dawidryba/wled-fence-post-light/docs/images/schematic_led.png

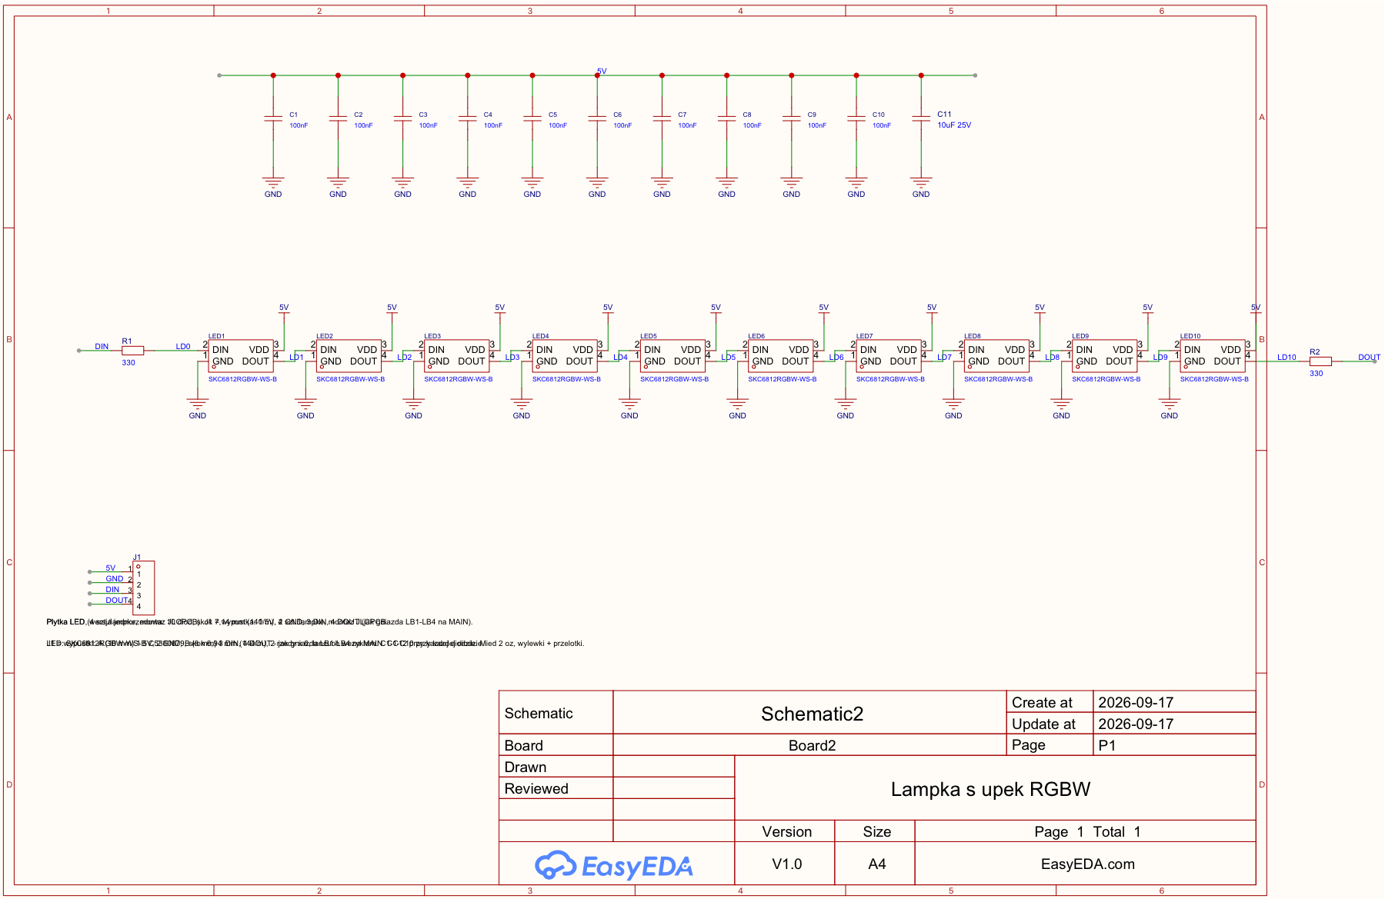
docs/images/schematic_led.png
