dawidryba/wled-fence-post-light/docs/pl/rys1_widok_z_gory.png

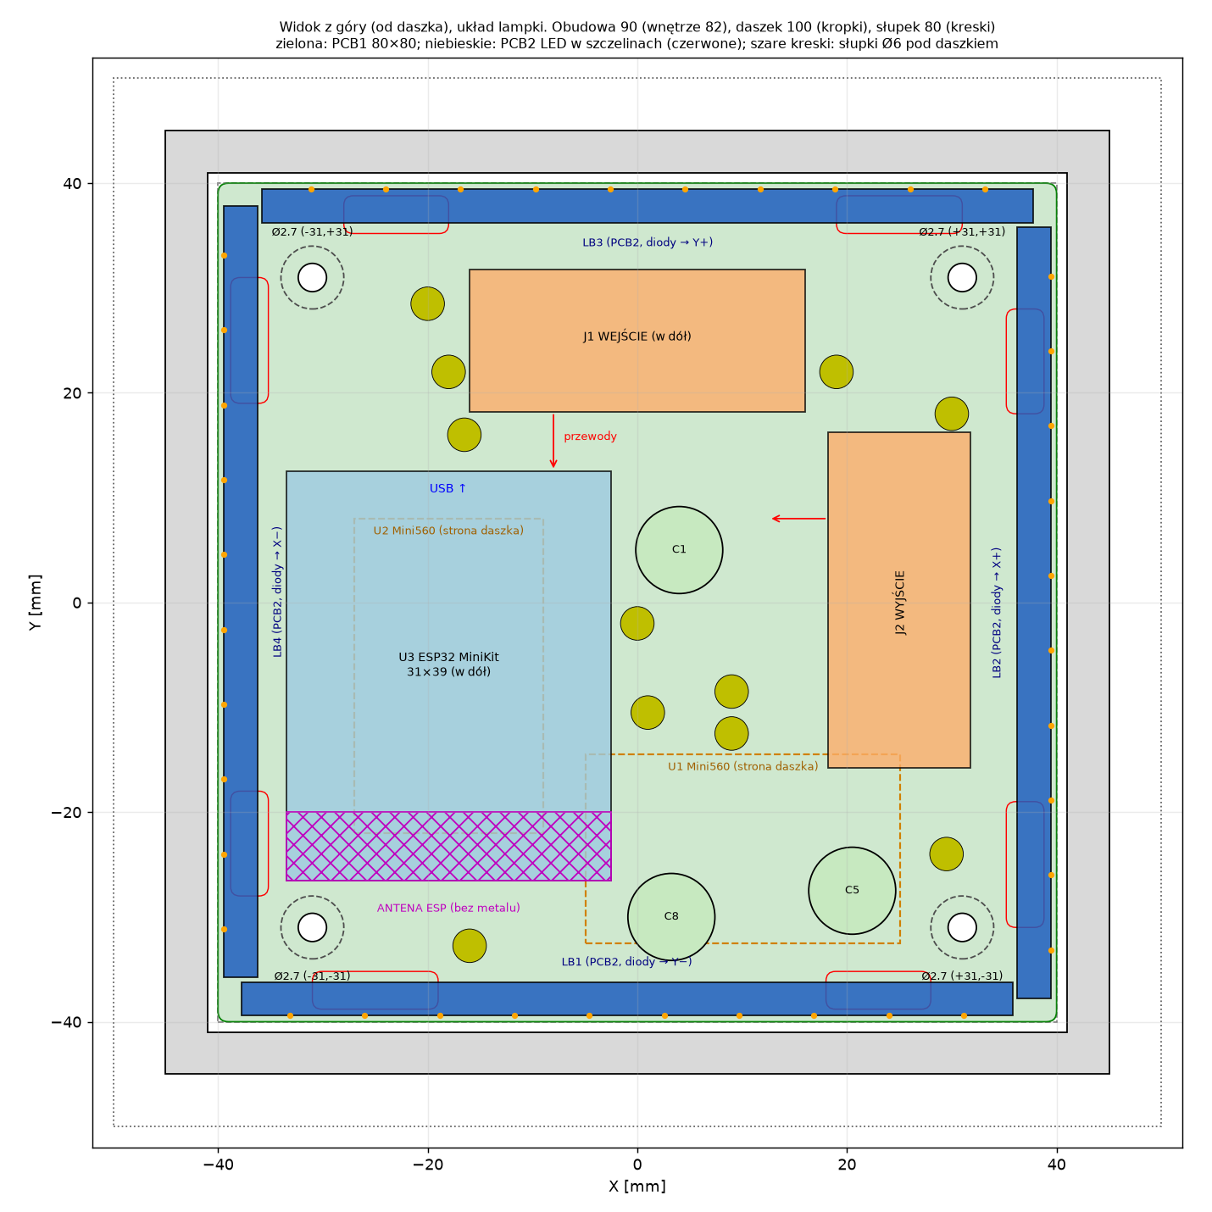
docs/pl/rys1_widok_z_gory.png
