dawidryba/wled-fence-post-light/docs/pl/rys2_przekroj.png

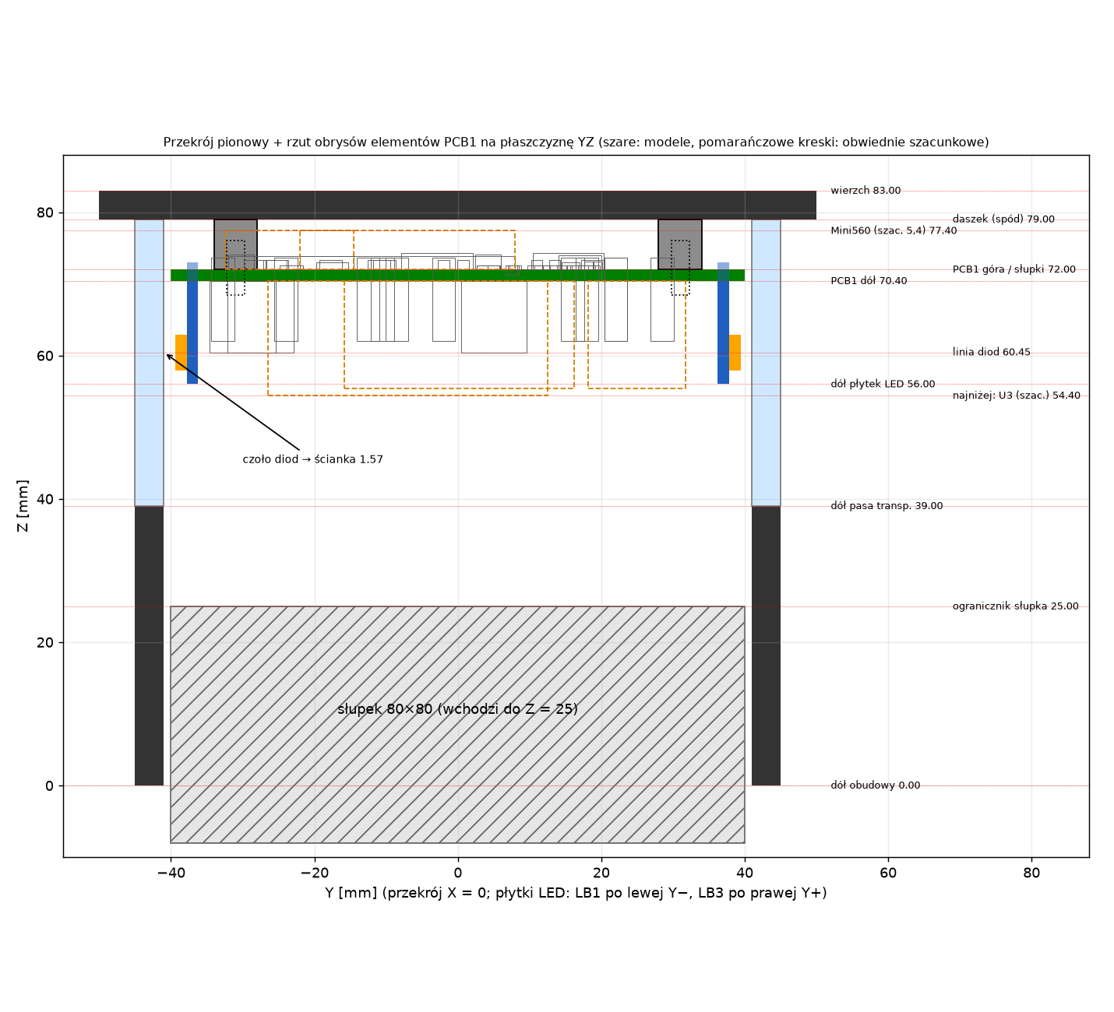
docs/pl/rys2_przekroj.png
