dawidryba/wled-fence-post-light/docs/pl/rys3_strefy_wysokosci.png

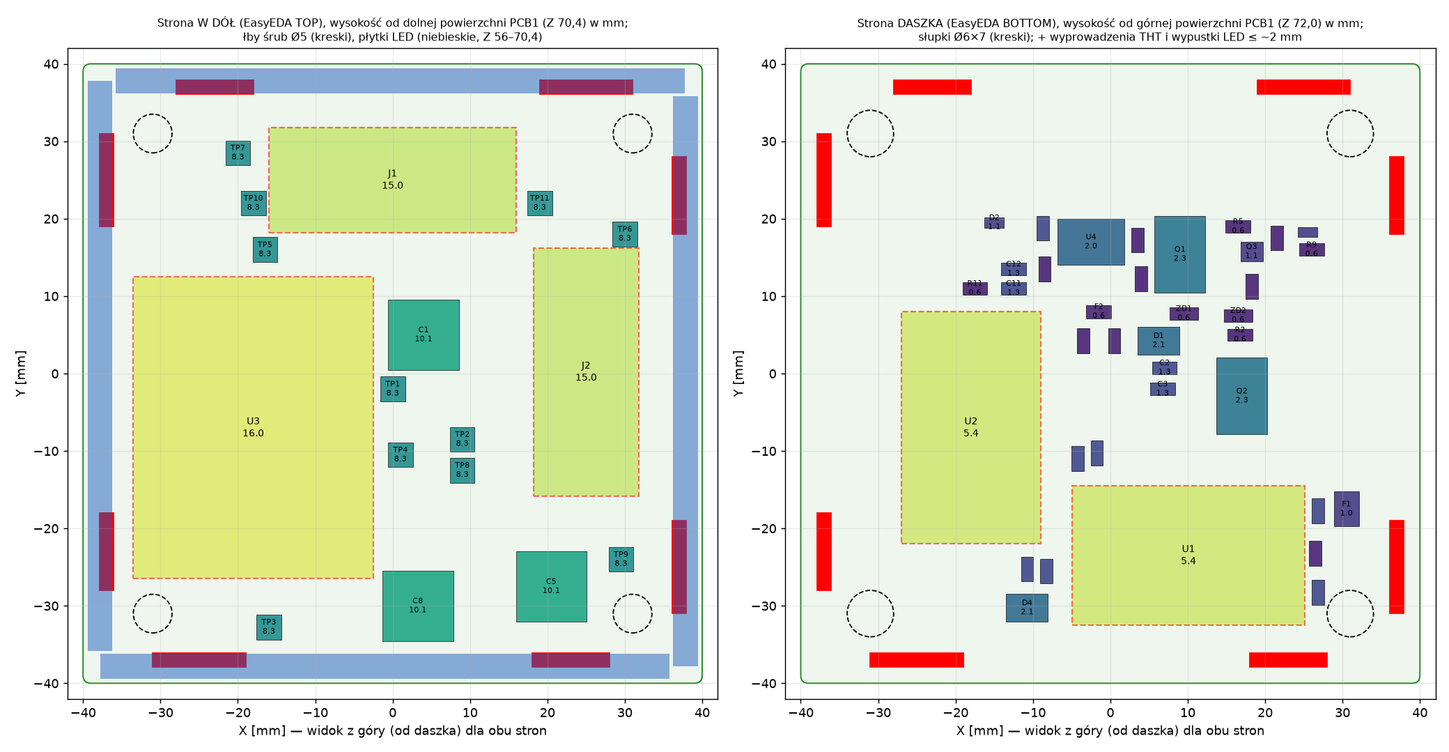
docs/pl/rys3_strefy_wysokosci.png
