dawidryba/wled-fence-post-light/pcb/manufacturing/PCB1_main_bom.csv

No. | Quantity | Comment | Designator | Footprint | Value | Manufacturer Part | Manufacturer | Supplier Part | Supplier
1 | 2 | 220uF 35V | C1,C5 | CAP-SMD_BD8.0-L8.3-W8.3-RD | 220uF 35V | VZH221M1VTR-0810 | Lelon(立隆) | VZH221M1VTR-0810.1 | LCSC
2 | 5 | 10uF 25V | C2,C6,C9,C11,C13 | C1206 | 10uF 25V | CL31B106KAHNNNE | SAMSUNG(三星) | CL31B106KAHNNNE.1 | LCSC
3 | 6 | 100nF | C3,C7,C10,C12,C14,C15 | C1206 | 100nF | CL31B104KBCNNNC | SAMSUNG(三星) | CL31B104KBCNNNC.1 | LCSC
4 | 1 | 470uF 16V | C8 | CAP-SMD_BD8.0-L8.3-W8.3-RD | 470uF 16V | VZH471M1CTR-0810 | Lelon(立隆) | VZH471M1CTR-0810.1 | LCSC
5 | 1 | SMBJ15A | D1 | SMB_L4.6-W3.6-LS5.3-RD |  | SMBJ15A | MDD(辰达半导体) | SMBJ15A_C113988.1 | LCSC
6 | 2 | PESD5V0S1BA | D2,D3 | SOD-323_L1.7-W1.3-LS2.5-BI |  | PESD5V0S1BA | TECH PUBLIC(台舟) | PESD5V0S1BA_C2827694.1 | LCSC
7 | 1 | SMBJ5.0A | D4 | SMB_L4.6-W3.6-LS5.3-RD | SMBJ5.0A | SMBJ5.0A | MDD(辰达半导体) | SMBJ5.0A-C113974.1 | LCSC
8 | 1 | 1812L300/30GR | F1 | F1812 | 3A PTC | 1812L300/30GR | LUTE(陆特) | 1812L300/30GR.1 | LCSC
9 | 1 | JK-nSMD050-30 | F2 | F1206 | 0.5A PTC | JK-nSMD050-30 | JK(金科) | JK-NSMD050-30V.1 | LCSC
10 | 1 | KF235-3.81 8P WEJSCIE | J1 | CONN-TH_16P-P3.50_2601-1108 |  | KF235-3.81-2P x4 (8 torow) | Cixi Kefa (KF235) | KF235-3.81-2P (AliExpress) | AliExpress
11 | 1 | KF235-3.81 8P WYJSCIE | J2 | CONN-TH_16P-P3.50_2601-1108 |  | KF235-3.81-2P x4 (8 torow) | Cixi Kefa (KF235) | KF235-3.81-2P (AliExpress) | AliExpress
12 | 1 | LAMPKA_SJ3 | JP1 | LAMPKA_SJ3 |  |  |  | PZ254V-11-03P_C2937625.1
13 | 4 | LAMPKA_LB_SLOT | LB1,LB2,LB3,LB4 | LAMPKA_LB_SLOT |  |  |  | PZ254V-11-04P.1
14 | 2 | AOD4185 | Q1,Q2 | TO-252-3_L6.6-W6.1-P4.57-LS9.9-BR-CW |  | AOD4185 | AOS | AOD4185_C400894.1 | LCSC
15 | 1 | 2N7002 | Q3 | SOT-23-3_L2.9-W1.3-P1.90-LS2.4-BR |  | 2N7002 | CJ(江苏长电/长晶) | 2N7002.1 | LCSC
16 | 2 | 47k | R1,R2 | R1206 | 47k | RC1206FR-0747KL | YAGEO(国巨) | RC1206FR-0747KL.1 | LCSC
17 | 1 | 4.7k | R3 | R1206 | 4.7k | 1206W4F4701T5E | UNI-ROYAL(厚声) | 1206W4F4701T5E.1 | LCSC
18 | 3 | 100 | R4,R6,R9 | R1206 | 100 | 1206W4F1000T5E | UNI-ROYAL(厚声) | 1206W4F1000T5E.1 | LCSC
19 | 2 | 100k | R5,R12 | R1206 | 100k | 1206W4F1003T5E | UNI-ROYAL(厚声) | 1206W4F1003T5E.1 | LCSC
20 | 1 | 220 | R7 | R1206 | 220 | 1206W4F2200T5E | UNI-ROYAL(厚声) | 1206W4F2200T5E.1 | LCSC
21 | 1 | 10k | R8 | R1206 | 10k | 1206W4F1002T5E | UNI-ROYAL(厚声) | 1206W4F1002T5E.1 | LCSC
22 | 2 | 2.2k | R10,R11 | R1206 | 2.2k | 1206W4F2201T5E | UNI-ROYAL(厚声) | 1206W4F2201T5E.1 | LCSC
23 | 4 | TP-红色测试点 | TP1,TP2,TP3,TP4 | TESTPOINT-TH_BD3.2 |  | TP-红色测试点 |  | TP-红色测试点.1 | LCSC
24 | 5 | TP-黄色测试点 | TP5,TP6,TP9,TP10,TP11 | TESTPOINT-TH_BD3.2 |  | TP-黄色测试点 |  | TP-黄色测试点.1 | LCSC
25 | 2 | TP-黑色测试点 | TP7,TP8 | TESTPOINT-TH_BD3.2 |  | TP-黑色测试点 |  | TP-黑色测试点.1 | LCSC
26 | 2 | mini5605V5A输出电源模块 | U1,U2 | COMM-SMD_MINI5605V5A |  | mini5605V5A输出电源模块 |  | MINI5605V5A输出电源模块.1 | LCSC
27 | 1 | ESP32 D1 Mini (MH-ET LIVE MiniKit) | U3 | LAMPKA_ESP32_MINIKIT |  | ESP32 D1 Mini (MH-ET LIVE MiniKit) |  | 12251210CNG0S190001.1
28 | 1 | SN74AHCT125DR | U4 | SOIC-14_L8.7-W3.9-P1.27-LS6.0-BL |  | SN74AHCT125DR | TI(德州仪器) | SN74AHCT125DR.1 | LCSC
29 | 2 | BZT52C12 | ZD1,ZD2 | SOD-123_L2.7-W1.6-LS3.7-RD | 12V | BZT52C12 | MDD(辰达半导体) | BZT52C12.1 | LCSC
