dawidryba/wled-fence-post-light/pcb/manufacturing/PCB2_LED_panel_bom.csv

No. | Quantity | Comment | Designator | Footprint | Value | Manufacturer Part | Manufacturer | Supplier Part | Supplier
1 | 10 | 100nF | C1,C2,C3,C4,C5,C6,C7,C8,C9,C10 | C0603 | 100nF | CC0603KRX7R9BB104 | YAGEO(国巨) | CC0603KRX7R9BB104.1 | LCSC
2 | 1 | 10uF 25V | C11 | C0805 | 10uF 25V | CL21A106KAYNNNE | SAMSUNG(三星) | CL21A106KAYNNNE.1 | LCSC
3 | 1 | LAMPKA_LED_TAB | J1 | LAMPKA_LED_TAB |  |  |  | PZ254V-11-04P.1
4 | 10 | SKC6812RGBW-WS-B | LED1,LED2,LED3,LED4,LED5,LED6,LED7,LED8,LED9,LED10 | LED-SMD_4P-L5.0-W4.9-BR |  | SKC6812RGBW-WS-B | OPSCO(欧思科) | SKC6812RGBW-WS-B.1 | LCSC
5 | 2 | 330 | R1,R2 | R0603 | 330 | 0603WAF3300T5E | UNI-ROYAL(厚声) | 0603WAF3300T5E.1 | LCSC
