dawidryba/wled-fence-post-light/pcb/step/electronics_assembly.step

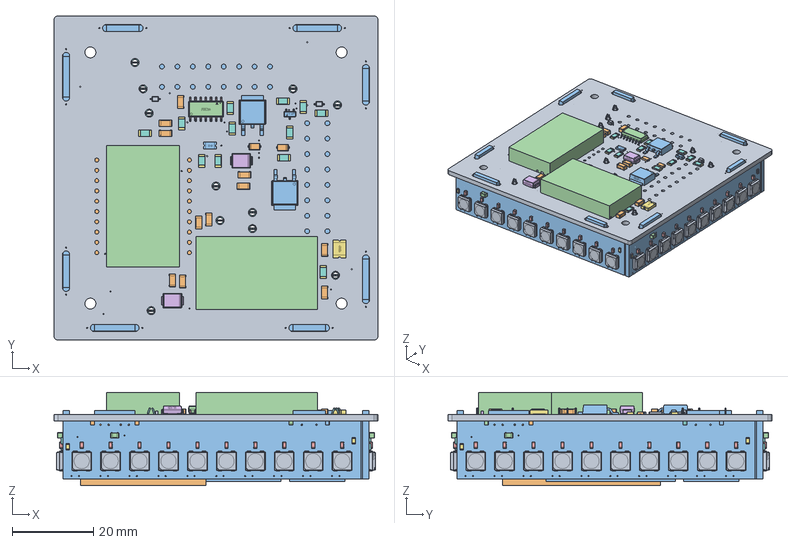
[picture p13: CAD file, 2026-10-31]
pcb/step/electronics_assembly.step
80.0 x 80.0 x 23.0 mm
Board~ostY
C1206~C1206_L3.2-W1.6-H1.3~duGf x 11
SOT-23-3_L2.9-W1.3-P1.90-LS2.4-BR~SOT-23-3P_ L2.9-W1.3-H1.0-LS2.4-P0.95~RIX3
SOT-23-3_L2.9-W1.3-P1.90-LS2.4-BR~SOT-23-3P_ L2.9-W1.3-H1.0-LS2.4-P0.95~RIX004
SOT-23-3_L2.9-W1.3-P1.90-LS2.4-BR~SOT-23-3P_ L2.9-W1.3-H1.0-LS2.4-P0.95~RIX005
SOT-23-3_L2.9-W1.3-P1.90-LS2.4-BR~SOT-23-3P_ L2.9-W1.3-H1.0-LS2.4-P0.95~RIX006
SOT-23-3_L2.9-W1.3-P1.90-LS2.4-BR~SOT-23-3P_ L2.9-W1.3-H1.0-LS2.4-P0.95~RIX007
SOT-23-3_L2.9-W1.3-P1.90-LS2.4-BR~SOT-23-3P_ L2.9-W1.3-H1.0-LS2.4-P0.95~RIX008
SOT-23-3_L2.9-W1.3-P1.90-LS2.4-BR~SOT-23-3P_ L2.9-W1.3-H1.0-LS2.4-P0.95~RIX009
SOT-23-3_L2.9-W1.3-P1.90-LS2.4-BR~SOT-23-3P_ L2.9-W1.3-H1.0-LS2.4-P0.95~RIX010
SOT-23-3_L2.9-W1.3-P1.90-LS2.4-BR~SOT-23-3P_ L2.9-W1.3-H1.0-LS2.4-P0.95~RIX011
SOT-23-3_L2.9-W1.3-P1.90-LS2.4-BR~SOT-23-3P_ L2.9-W1.3-H1.0-LS2.4-P0.95~RIX012
SOT-23-3_L2.9-W1.3-P1.90-LS2.4-BR~SOT-23-3P_ L2.9-W1.3-H1.0-LS2.4-P0.95~RIX013
SOT-23-3_L2.9-W1.3-P1.90-LS2.4-BR~SOT-23-3P_ L2.9-W1.3-H1.0-LS2.4-P0.95~RIX014
SOT-23-3_L2.9-W1.3-P1.90-LS2.4-BR~SOT-23-3P_ L2.9-W1.3-H1.0-LS2.4-P0.95~RIX015
SOT-23-3_L2.9-W1.3-P1.90-LS2.4-BR~SOT-23-3P_ L2.9-W1.3-H1.0-LS2.4-P0.95~RIX016
SOT-23-3_L2.9-W1.3-P1.90-LS2.4-BR~SOT-23-3P_ L2.9-W1.3-H1.0-LS2.4-P0.95~RIX017
SOT-23-3_L2.9-W1.3-P1.90-LS2.4-BR~SOT-23-3P_ L2.9-W1.3-H1.0-LS2.4-P0.95~RIX018
SOT-23-3_L2.9-W1.3-P1.90-LS2.4-BR~SOT-23-3P_ L2.9-W1.3-H1.0-LS2.4-P0.95~RIX019
SMB_L4.6-W3.6-LS5.3-RD~SMB_L4.6-W3.6-LS5.3-RD~o7Bd x 2
R1206~R1206_L3.2-W1.6-H0.6~9JtB x 12
R1206~R1206_L3.2-W1.6-H0.6~9JtB001 x 12
R1206~R1206_L3.2-W1.6-H0.6~9JtB002 x 12
SOD-123_L2.7-W1.6-LS3.7-RD~SOD-123_L2.7-W1.6-H1.4-LS3.7~yyUm x 2
F1206~F1206_L3.2-W1.7-H0.6~Ill9
SOIC-14_L8.7-W3.9-P1.27-LS6.0-BL~SOIC-14_ L8.6-W3.9-H1.8-LS6.0-P1.27~Mzfl
SOIC-14_L8.7-W3.9-P1.27-LS6.0-BL~SOIC-14_ L8.6-W3.9-H1.8-LS6.0-P1.27~Mzfl001
SOIC-14_L8.7-W3.9-P1.27-LS6.0-BL~SOIC-14_ L8.6-W3.9-H1.8-LS6.0-P1.27~Mzfl002
SOIC-14_L8.7-W3.9-P1.27-LS6.0-BL~SOIC-14_ L8.6-W3.9-H1.8-LS6.0-P1.27~Mzfl003
SOIC-14_L8.7-W3.9-P1.27-LS6.0-BL~SOIC-14_ L8.6-W3.9-H1.8-LS6.0-P1.27~Mzfl004
SOIC-14_L8.7-W3.9-P1.27-LS6.0-BL~SOIC-14_ L8.6-W3.9-H1.8-LS6.0-P1.27~Mzfl005
SOIC-14_L8.7-W3.9-P1.27-LS6.0-BL~SOIC-14_ L8.6-W3.9-H1.8-LS6.0-P1.27~Mzfl006
SOIC-14_L8.7-W3.9-P1.27-LS6.0-BL~SOIC-14_ L8.6-W3.9-H1.8-LS6.0-P1.27~Mzfl007
SOIC-14_L8.7-W3.9-P1.27-LS6.0-BL~SOIC-14_ L8.6-W3.9-H1.8-LS6.0-P1.27~Mzfl008
SOIC-14_L8.7-W3.9-P1.27-LS6.0-BL~SOIC-14_ L8.6-W3.9-H1.8-LS6.0-P1.27~Mzfl009
SOIC-14_L8.7-W3.9-P1.27-LS6.0-BL~SOIC-14_ L8.6-W3.9-H1.8-LS6.0-P1.27~Mzfl010
SOIC-14_L8.7-W3.9-P1.27-LS6.0-BL~SOIC-14_ L8.6-W3.9-H1.8-LS6.0-P1.27~Mzfl011
SOIC-14_L8.7-W3.9-P1.27-LS6.0-BL~SOIC-14_ L8.6-W3.9-H1.8-LS6.0-P1.27~Mzfl012
SOIC-14_L8.7-W3.9-P1.27-LS6.0-BL~SOIC-14_ L8.6-W3.9-H1.8-LS6.0-P1.27~Mzfl013
SOIC-14_L8.7-W3.9-P1.27-LS6.0-BL~SOIC-14_ L8.6-W3.9-H1.8-LS6.0-P1.27~Mzfl014
SOIC-14_L8.7-W3.9-P1.27-LS6.0-BL~SOIC-14_ L8.6-W3.9-H1.8-LS6.0-P1.27~Mzfl015
SOIC-14_L8.7-W3.9-P1.27-LS6.0-BL~SOIC-14_ L8.6-W3.9-H1.8-LS6.0-P1.27~Mzfl016
SOIC-14_L8.7-W3.9-P1.27-LS6.0-BL~SOIC-14_ L8.6-W3.9-H1.8-LS6.0-P1.27~Mzfl017
SOIC-14_L8.7-W3.9-P1.27-LS6.0-BL~SOIC-14_ L8.6-W3.9-H1.8-LS6.0-P1.27~Mzfl018
SOIC-14_L8.7-W3.9-P1.27-LS6.0-BL~SOIC-14_ L8.6-W3.9-H1.8-LS6.0-P1.27~Mzfl019
SOIC-14_L8.7-W3.9-P1.27-LS6.0-BL~SOIC-14_ L8.6-W3.9-H1.8-LS6.0-P1.27~Mzfl020
SOIC-14_L8.7-W3.9-P1.27-LS6.0-BL~SOIC-14_ L8.6-W3.9-H1.8-LS6.0-P1.27~Mzfl021
SOIC-14_L8.7-W3.9-P1.27-LS6.0-BL~SOIC-14_ L8.6-W3.9-H1.8-LS6.0-P1.27~Mzfl022
SOIC-14_L8.7-W3.9-P1.27-LS6.0-BL~SOIC-14_ L8.6-W3.9-H1.8-LS6.0-P1.27~Mzfl023
SOIC-14_L8.7-W3.9-P1.27-LS6.0-BL~SOIC-14_ L8.6-W3.9-H1.8-LS6.0-P1.27~Mzfl024
SOIC-14_L8.7-W3.9-P1.27-LS6.0-BL~SOIC-14_ L8.6-W3.9-H1.8-LS6.0-P1.27~Mzfl025
SOIC-14_L8.7-W3.9-P1.27-LS6.0-BL~SOIC-14_ L8.6-W3.9-H1.8-LS6.0-P1.27~Mzfl026
SOIC-14_L8.7-W3.9-P1.27-LS6.0-BL~SOIC-14_ L8.6-W3.9-H1.8-LS6.0-P1.27~Mzfl027
F1812~F1812_L4.5-W3.2-H1.0~vHM2
TESTPOINT-TH_BD3.2~TESTPOINT-TH_BD3.2~D4CD x 11
SOD-323_L1.7-W1.3-LS2.5-BI~SOD-323_L1.7-W1.3-LS2.5-BI~kZJh x 2
SOD-323_L1.7-W1.3-LS2.5-BI~SOD-323_L1.7-W1.3-LS2.5-BI~kZJh001 x 2
SOD-323_L1.7-W1.3-LS2.5-BI~SOD-323_L1.7-W1.3-LS2.5-BI~kZJh002 x 2
SOD-323_L1.7-W1.3-LS2.5-BI~SOD-323_L1.7-W1.3-LS2.5-BI~kZJh003 x 2
SOD-323_L1.7-W1.3-LS2.5-BI~SOD-323_L1.7-W1.3-LS2.5-BI~kZJh004 x 2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
