dawidryba/wled-fence-post-light/enclosure/exports/lampka_kliny_x4.stl

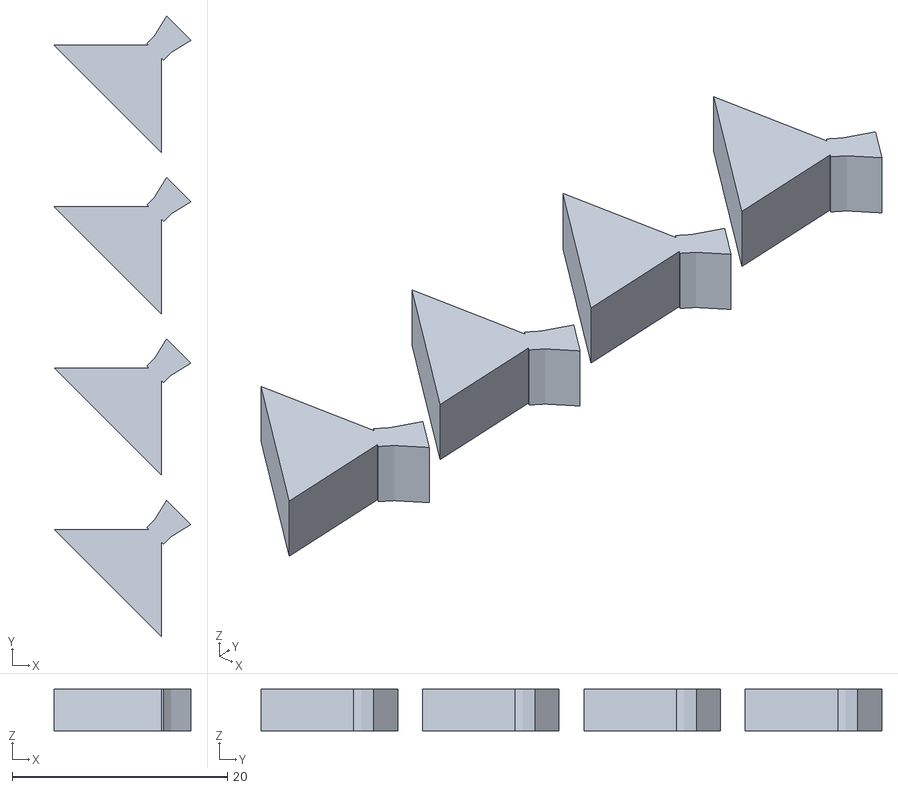
[picture p14: CAD file, 2026-10-31]
enclosure/exports/lampka_kliny_x4.stl
12.7 x 57.7 x 3.90
