dawidryba/wled-fence-post-light/enclosure/makerworld/Fence_post_light_80x80_PETG_AMS.3mf

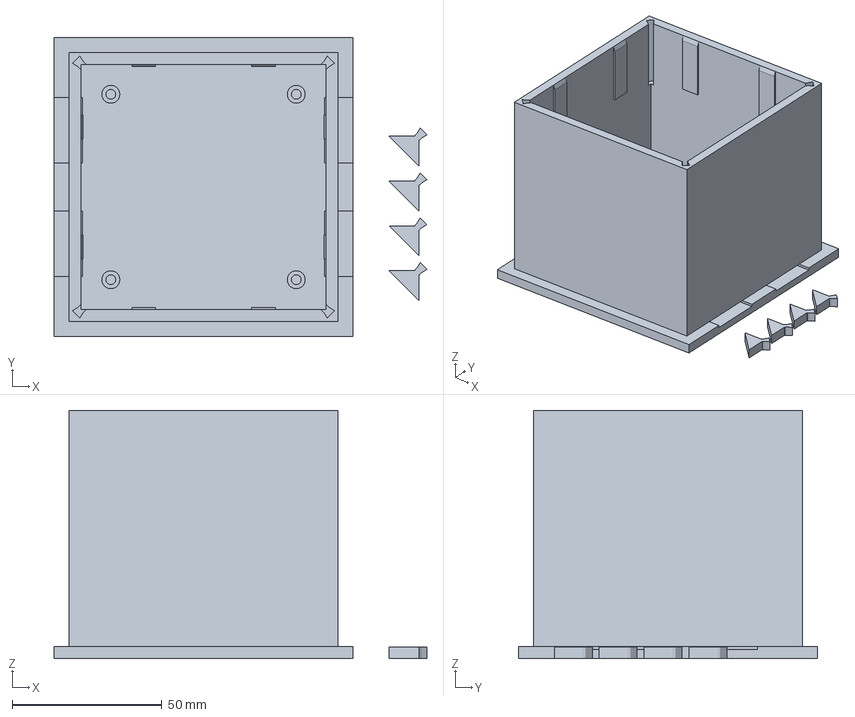
[picture p15: CAD file, 2026-10-31]
enclosure/makerworld/Fence_post_light_80x80_PETG_AMS.3mf
124.7 x 100.0 x 83.0 mm
