dawidryba/wled-fence-post-light/enclosure/exports/lampka.step

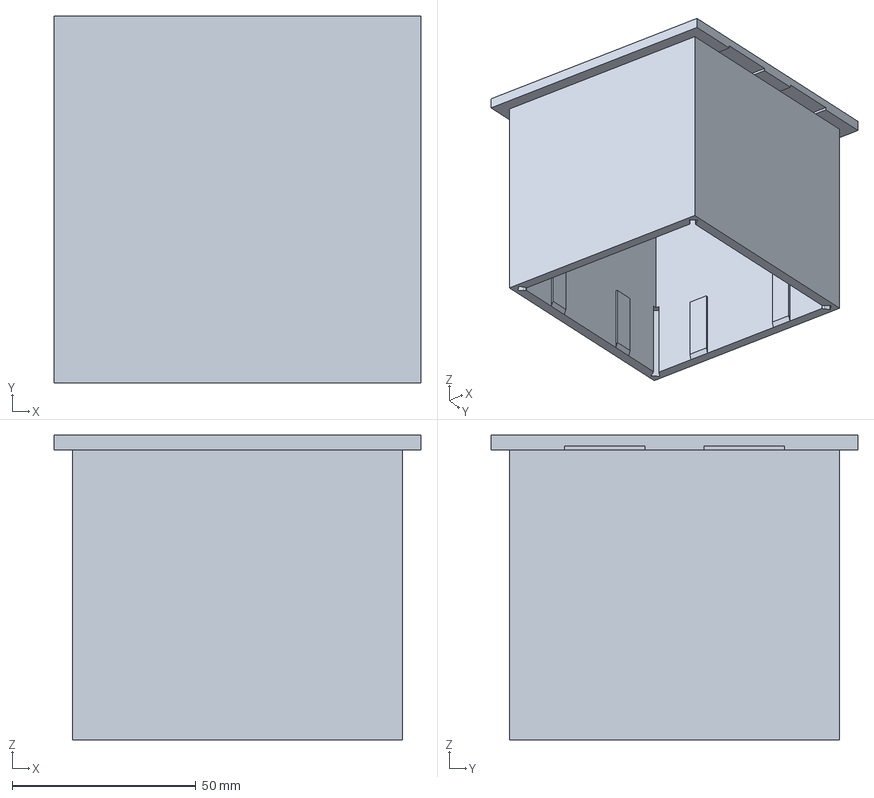
[picture p16: CAD file, 2026-10-31]
enclosure/exports/lampka.step
100.0 x 100.0 x 83.0 mm
