dawidryba/wled-fence-post-light/enclosure/exports/lampka_czarny_dol.stl

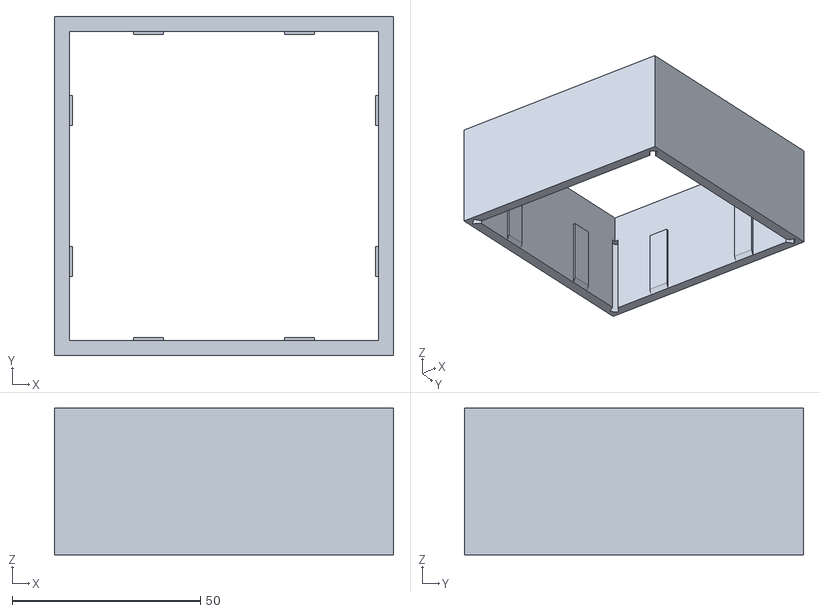
[picture p17: CAD file, 2026-10-31]
enclosure/exports/lampka_czarny_dol.stl
90.0 x 90.0 x 39.0
