dawidryba/wled-fence-post-light/enclosure/exports/lampka_pas_transparentny.stl

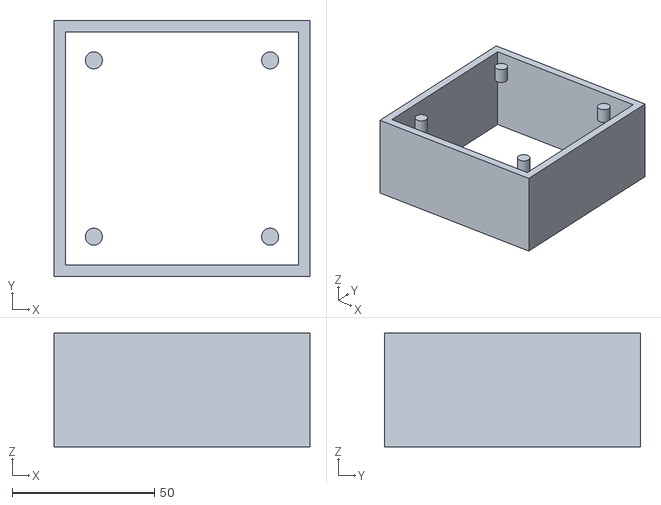
[picture p18: CAD file, 2026-10-31]
enclosure/exports/lampka_pas_transparentny.stl
90.0 x 90.0 x 40.0
