dawidryba/wled-fence-post-light/enclosure/exports/lampka_czarny_daszek.stl

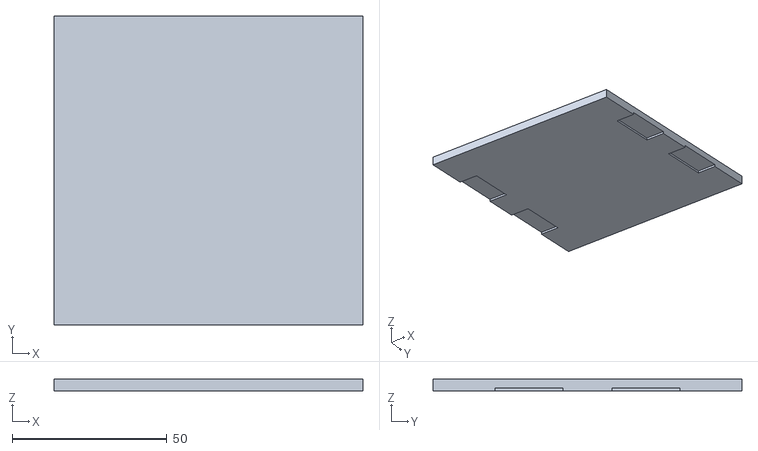
[picture p19: CAD file, 2026-10-31]
enclosure/exports/lampka_czarny_daszek.stl
100.0 x 100.0 x 4.00
