dawidryba/wled-fence-post-light/enclosure/exports/lampka_klin.step

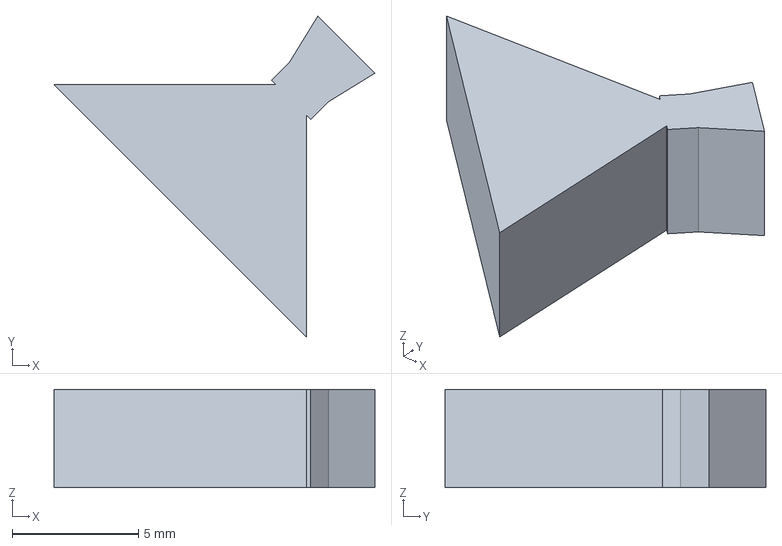
[picture p20: CAD file, 2026-10-31]
enclosure/exports/lampka_klin.step
12.7 x 12.7 x 3.90 mm
