dawidryba/wled-fence-post-light/docs/schematic_led.pdf

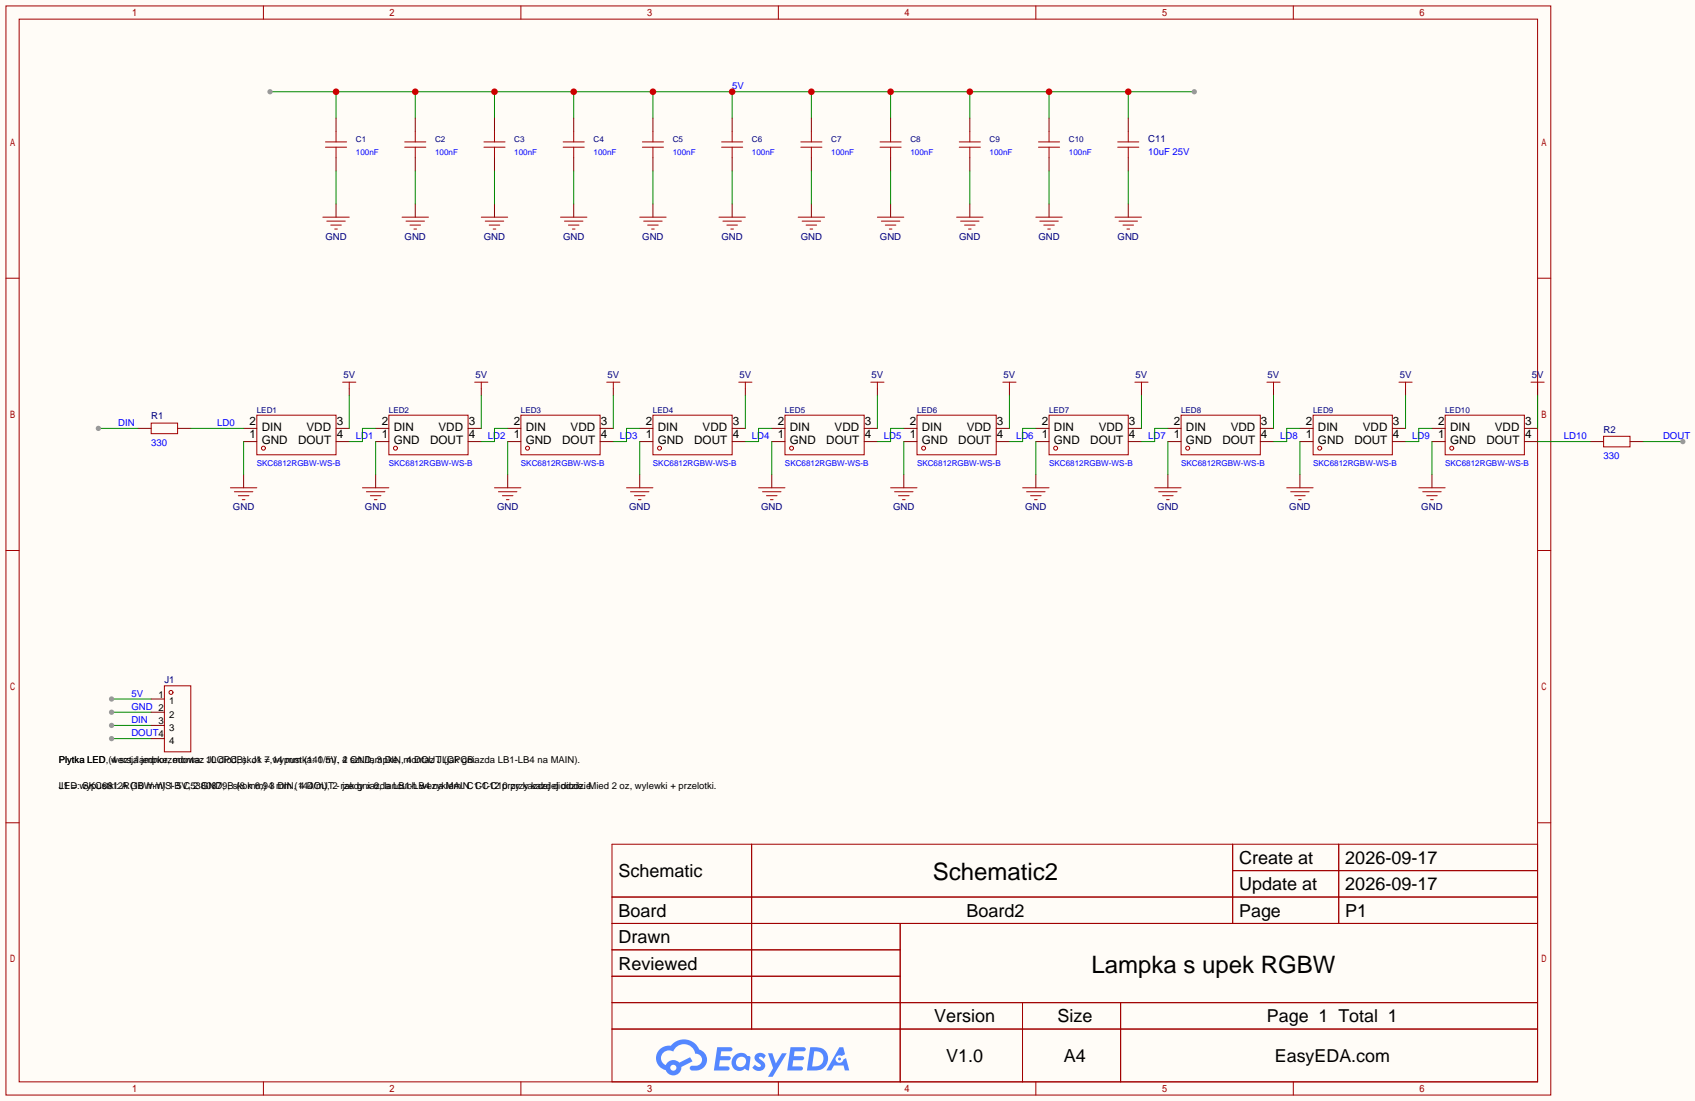
[picture p21: page 1]

Plytka LED (4 szt./lampke, montaz JLCPCB). J1 = wypustka: 1 5V, 2 GND, 3 DIN, 4 DOUT (jak gniazda LB1-LB4 na MAIN).

Plytka LED, wersja jednorzedowa: 10 diod, skok 7,14 mm (140/m). 4 szt./lampke, montaz JLCPCB.

LED: SKC6812RGBW-WS-B C5380879, skok 6,94 mm (144/m), 2 rzedy x 6, lancuch wezykiem. C1-C12 przy kazdej diodzie. Mied 2 oz, wylewki + przelotki.

J1 = wypustki: A (10 mm) 1 5V, 2 GND; B (8 mm) 3 DIN, 4 DOUT - jak gniazda LB1-LB4 na MAIN. C1-C10 przy kazdej diodzie.

Schematic | Schematic2 | Create at | 2026-09-17

Update at | 2026-09-17

Board | Board2 | Page | P1
Drawn | | Lampka s upek RGBW
Reviewed

Version | Size | Page 1 Total 1
V1.0 | A4 | EasyEDA.com
