dawidryba/wled-fence-post-light/docs/schematic_main.pdf

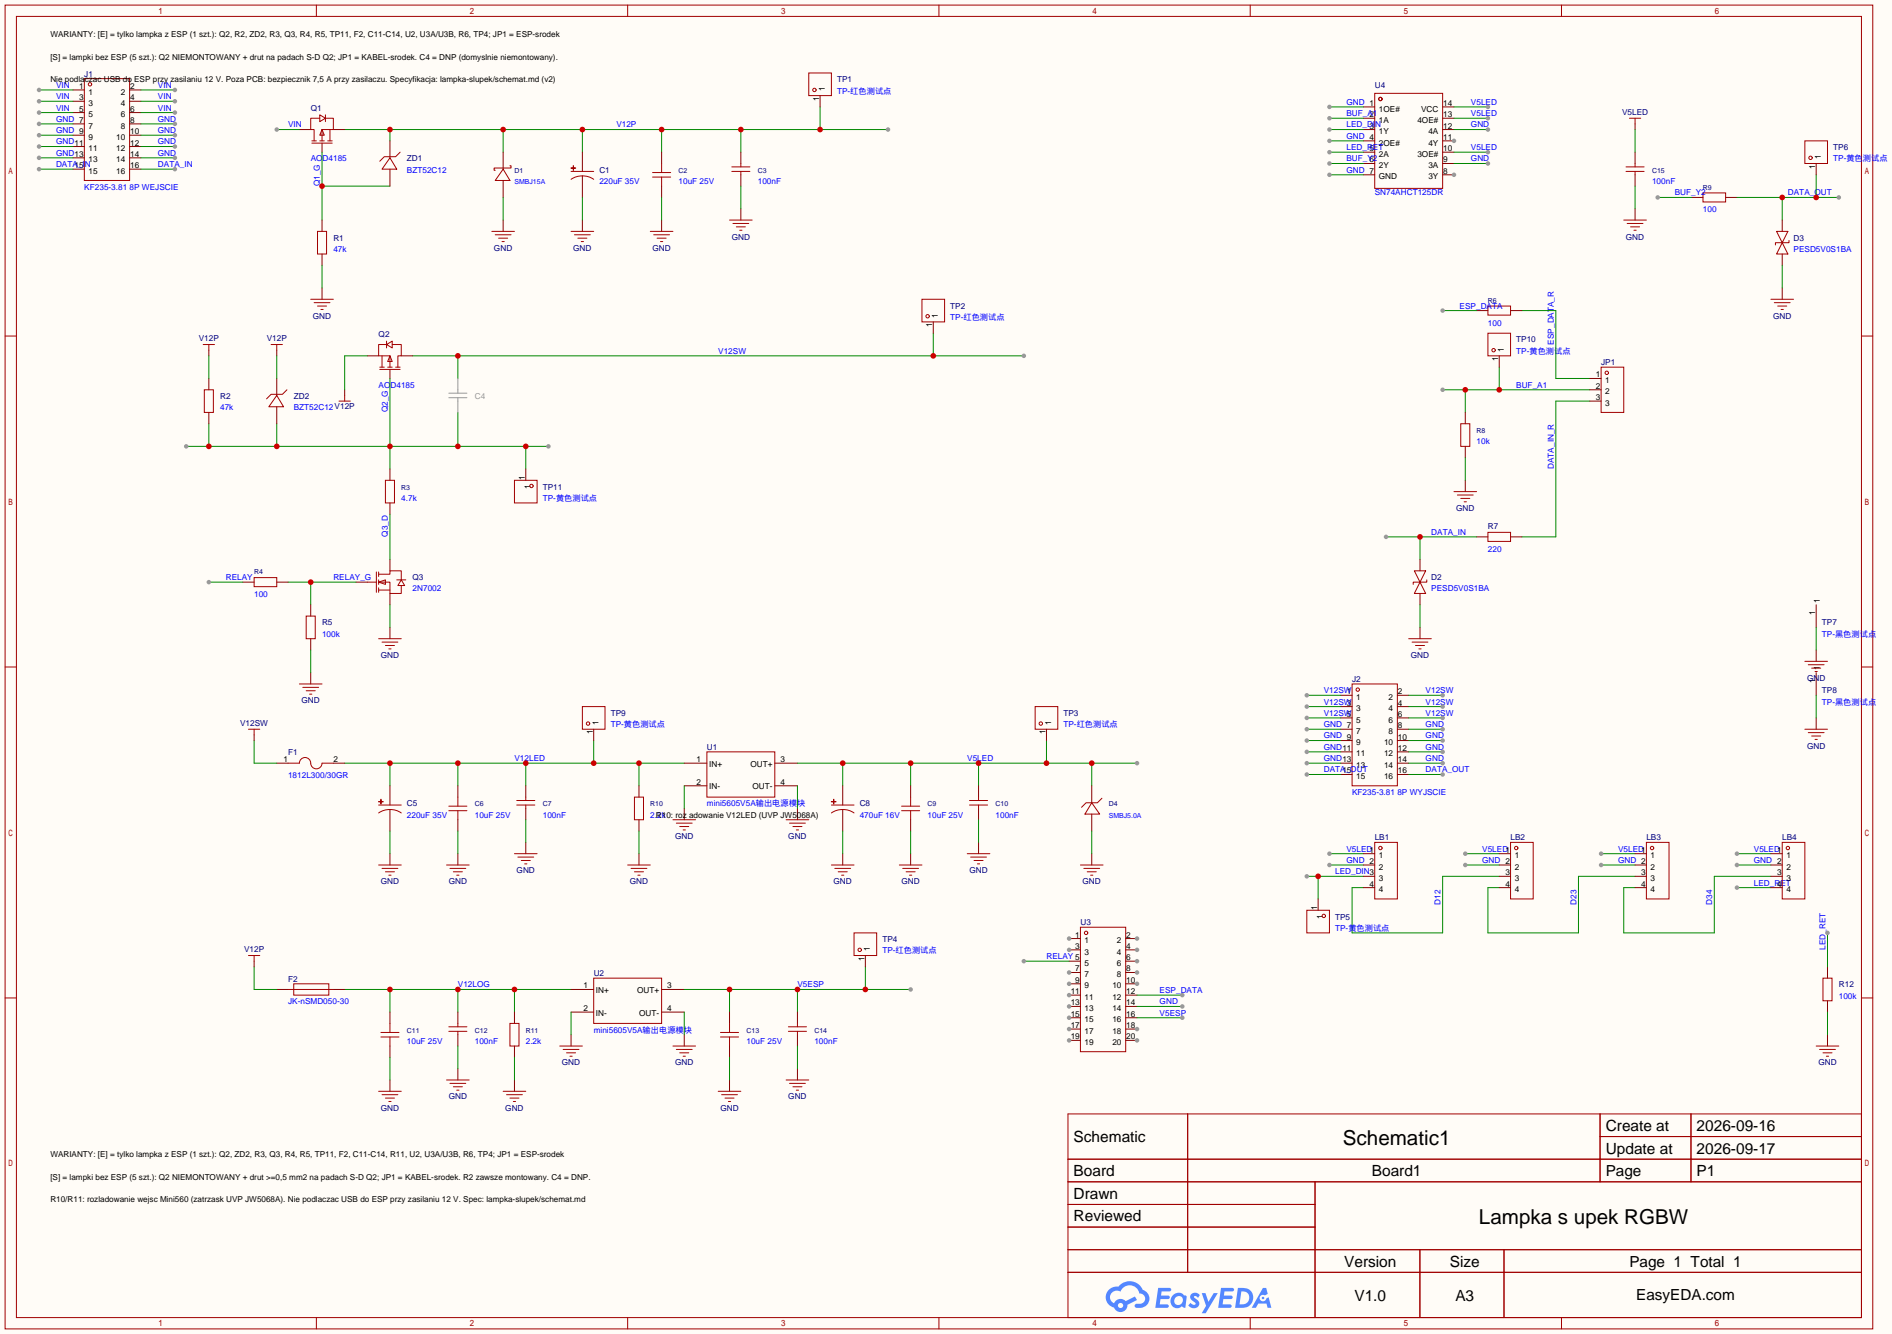
[picture p22: page 1]

WARIANTY: [E] = tylko lampka z ESP (1 szt.): Q2, R2, ZD2, R3, Q3, R4, R5, TP11, F2, C11-C14, U2, U3A/U3B, R6, TP4; JP1 = ESP-srodek

[S] = lampki bez ESP (5 szt.): Q2 NIEMONTOWANY + drut na padach S-D Q2; JP1 = KABEL-srodek. C4 = DNP (domyslnie niemontowany).

Nie podlaczac USB do ESP przy zasilaniu 12 V. Poza PCB: bezpiecznik 7,5 A przy zasilaczu. Specyfikacja: lampka-slupek/schemat.md (v2)

Schematic | Schematic1 | Create at | 2026-09-16

WARIANTY: [E] = tylko lampka z ESP (1 szt.): Q2, ZD2, R3, Q3, R4, R5, TP11, F2, C11-C14, R11, U2, U3A/U3B, R6, TP4; JP1 = ESP-srodek

Update at | 2026-09-17

Board | Board1 | Page | P1
Drawn | | Lampka s upek RGBW
Reviewed

[S] = lampki bez ESP (5 szt.): Q2 NIEMONTOWANY + drut >=0,5 mm2 na padach S-D Q2; JP1 = KABEL-srodek. R2 zawsze montowany. C4 = DNP.

R10/R11: rozladowanie wejsc Mini560 (zatrzask UVP JW5068A). Nie podlaczac USB do ESP przy zasilaniu 12 V. Spec: lampka-slupek/schemat.md

Version | Size | Page 1 Total 1
V1.0 | A3 | EasyEDA.com
